nick-burrill/mPMT_Development/mPMT Assembly/Templates/Parts/readme.md

# Part Name v# # 

Part Preview

**Model Source:** \
**Part Source:** \
**Last Update:** \
**Material:** \
**Aditional Notes:**
