nick-burrill/mPMT_Development/mPMT Assembly/Parts/Acrylic Dome/v1/readme.md

# Acrylic Dome v1 # 

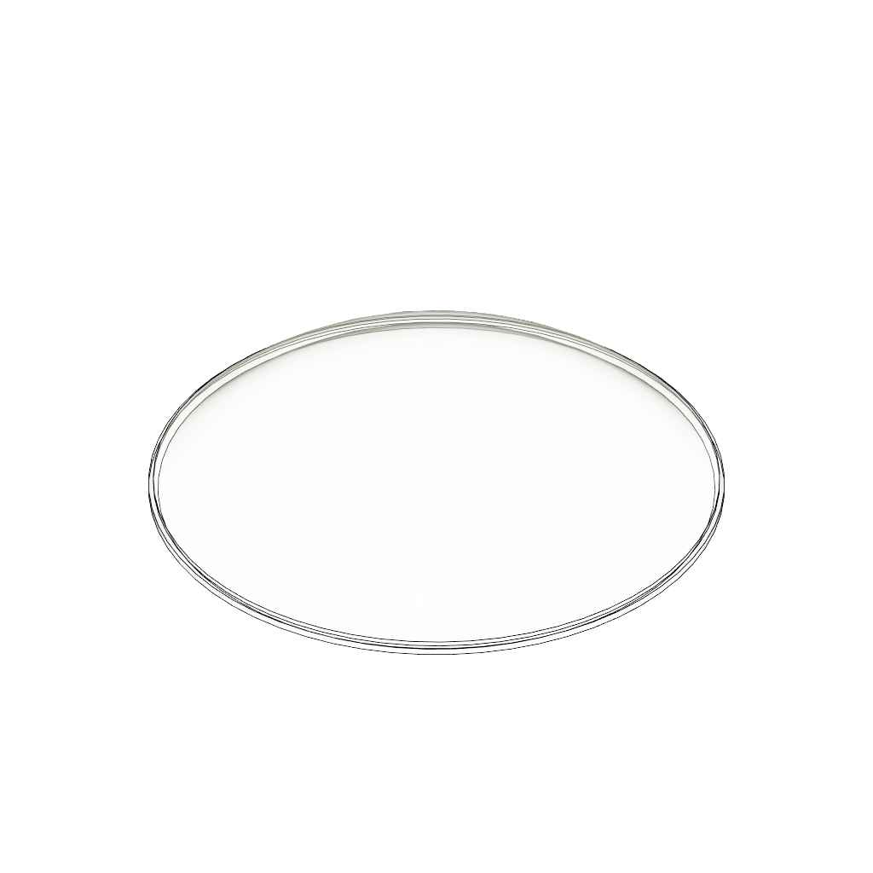
[picture p2: mPMT Assembly/Parts/Acrylic Dome/v1/thumb.png]
Part Preview


**Model Source:** Sent from previous designer \
**Part Source:** \
**Last Update:** ~September 2022 \
**Material:** Acrylic \
**Aditional Notes:**
