nick-burrill/mPMT_Development/mPMT Assembly/Parts/Aluminum Ring/v1/readme.md

# Aluminum Ring v1# # 

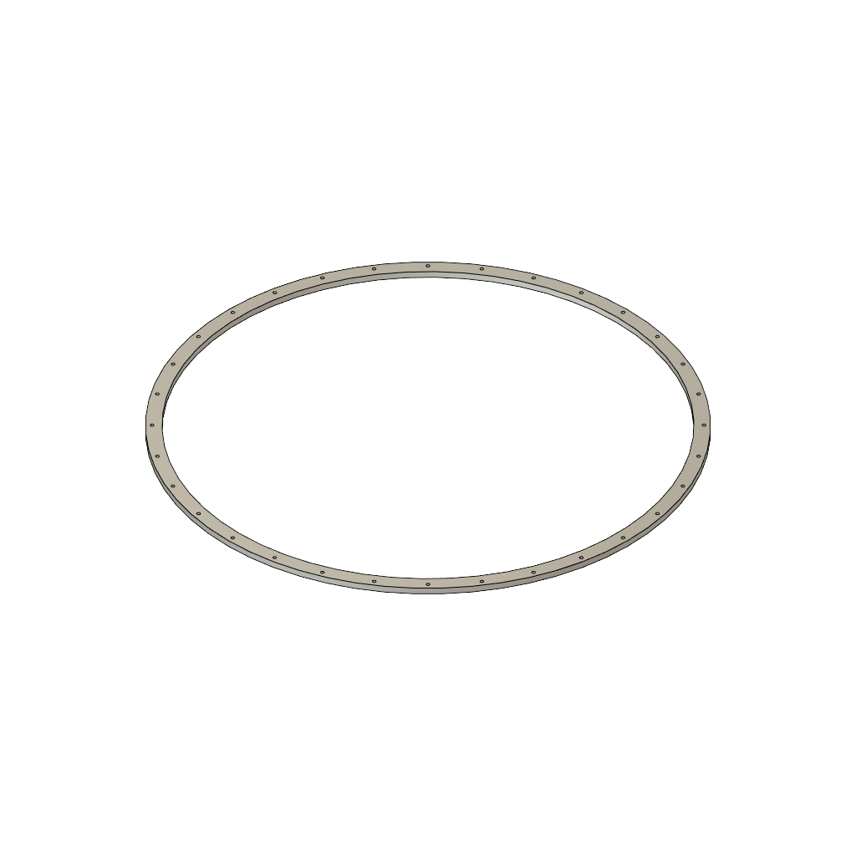
[picture p3: mPMT Assembly/Parts/Aluminum Ring/v1/thumb.png]
Part Preview


**Model Source:** Sent from previous designer \
**Part Source:** \
**Last Update:** ~September 2022 \
**Material:** 6061 Aluminum \
**Aditional Notes:**
