nick-burrill/mPMT_Development/mPMT Assembly/Parts/Back Plane/v1/readme.md

# Back Plane (XDE2411) v1 # 

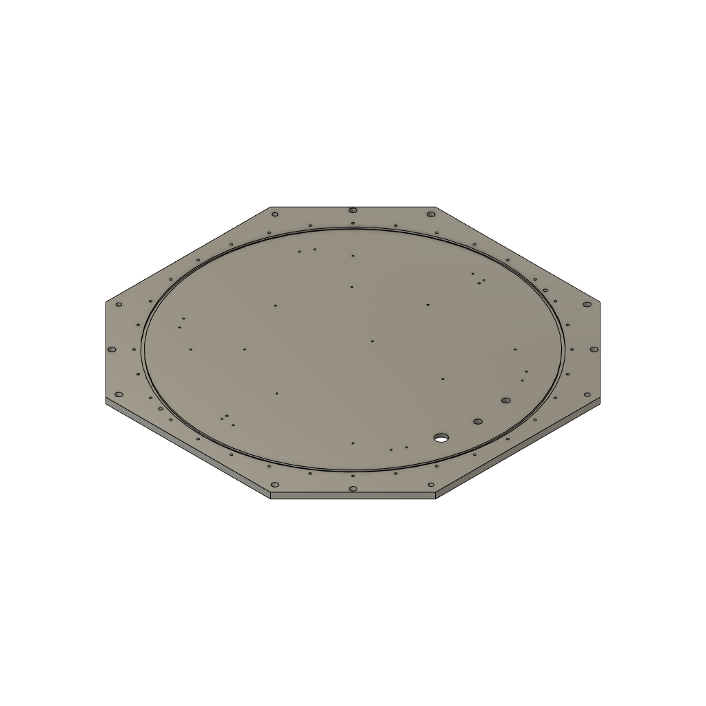
[picture p4: mPMT Assembly/Parts/Back Plane/v1/thumb.png]
Part Preview


**Model Source:** Sent from previous designer \
**Part Source:** \
**Last Update:** ~September 2022 \
**Material:** Stainless Steel\
**Aditional Notes:**
