nick-burrill/mPMT_Development/mPMT Assembly/Parts/Dome Standoff/v1/readme.md

# Dome Standoff v1 # 

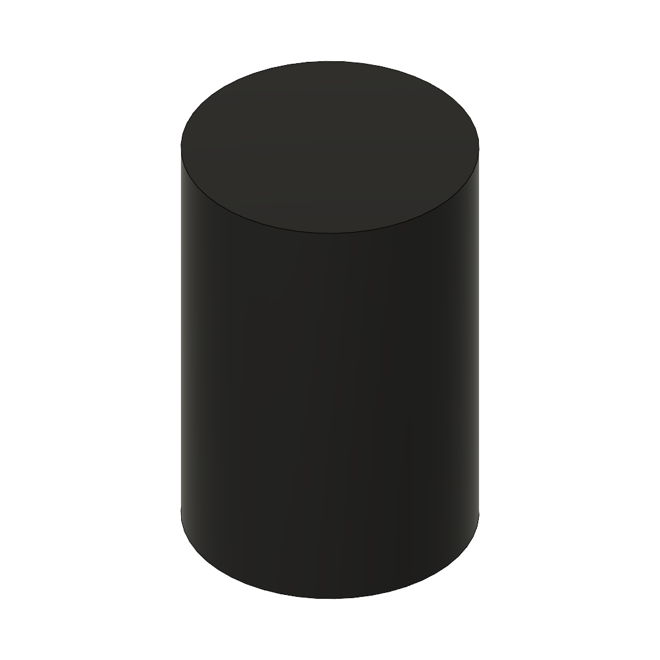
[picture p5: mPMT Assembly/Parts/Dome Standoff/v1/thumb.png]
Part Preview


**Model Source:** Modeled by Nick Burrill \
**Part Source:** Made at Carleton \
**Last Update:** November 10th 2022 \
**Material:** 1/2" Delrin rod stock \
**Aditional Notes:**
