nick-burrill/mPMT_Development/mPMT Assembly/Parts/Pillars/v1/readme.md

# Pillar (v4.0.1) v1 # 

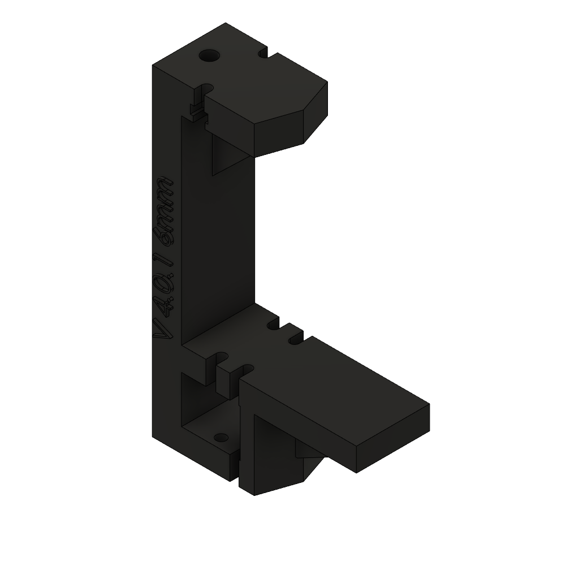
[picture p6: mPMT Assembly/Parts/Pillars/v1/thumb.png]
Part Preview


**Model Source:** Sent from previous designer \
**Part Source:** \
**Last Update:** ~September 2022 \
**Material:** 3d printed ABS \
**Aditional Notes:**
