nick-burrill/mPMT_Development/mPMT Assembly/Parts/PMT Array/v1/readme.md

# PMT Array v1 # 

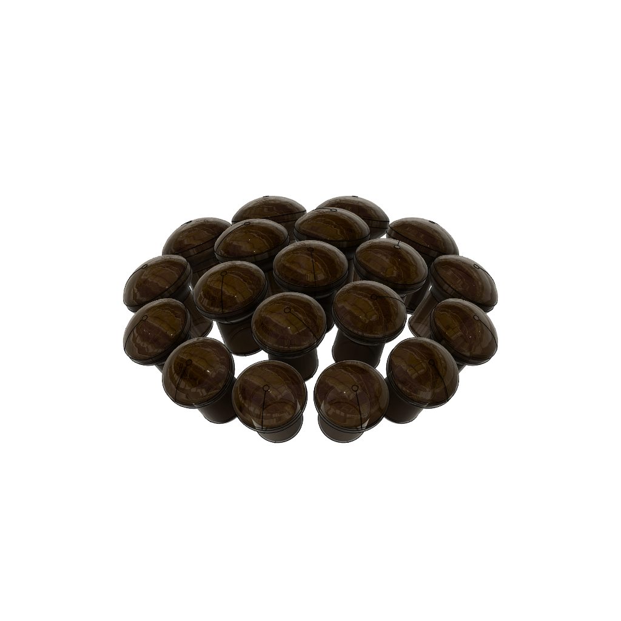
[picture p7: mPMT Assembly/Parts/PMT Array/v1/thumb.png]
Part Preview


**Model Source:** Sent from previous designer \
**Part Source:** Hamamatsu
**Last Update:** ~September 2022 \
**Material:** \
**Aditional Notes:** Dummy PMT are a baseless varient of [Hamamatsu R14374 Photomultiplier Tube](https://www.hamamatsu.com/us/en/product/optical-sensors/pmt/pmt_tube-alone/head-on-type/R14374.html)
