nick-burrill/mPMT_Development/mPMT Assembly/Parts/PVC Cylinder/v1/readme.md

# PVC Cylinder (XDE2431) v1 # 

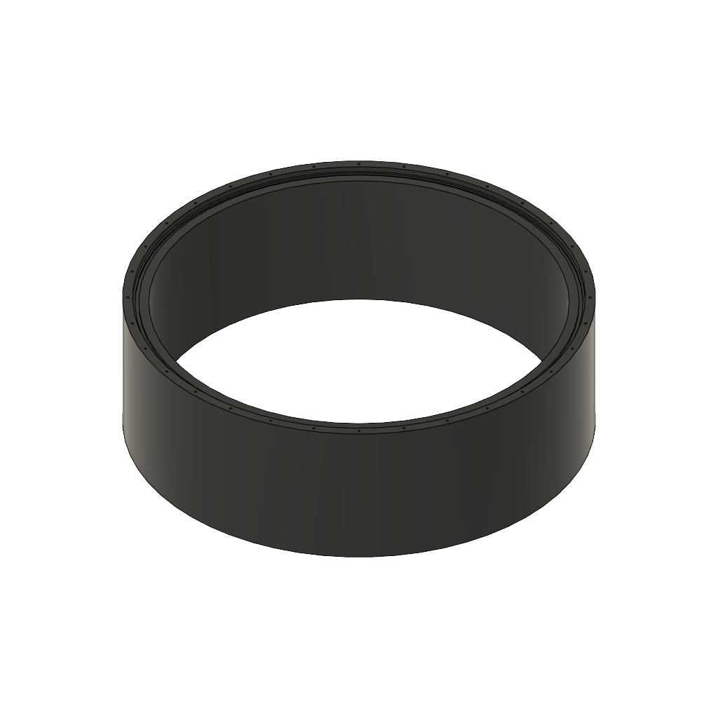
[picture p8: mPMT Assembly/Parts/PVC Cylinder/v1/thumb.png]
Part Preview


**Model Source:** Sent from previous designer \
**Part Source:** Made at Carleton \
**Last Update:** ~September 2022 \
**Material:** PVC pipe \
**Aditional Notes:**
