nick-burrill/mPMT_Development/mPMT Assembly/Parts/Acrylic Dome/v1/Acrylic Dome v1.step

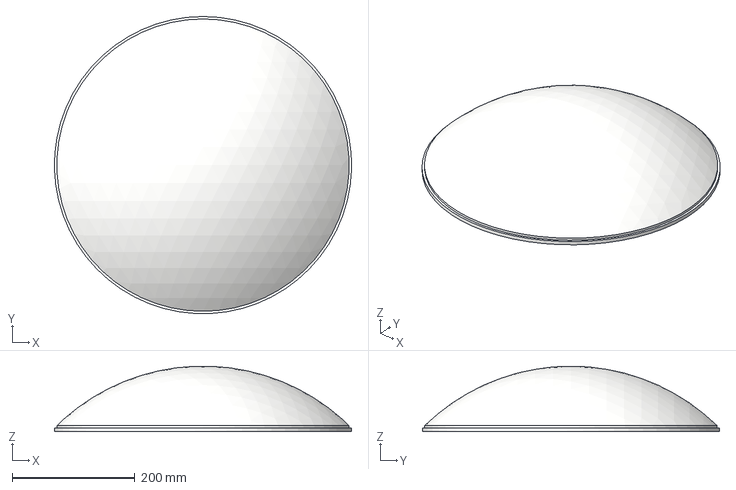
[picture p10: CAD file, 2023-03-15]
mPMT Assembly/Parts/Acrylic Dome/v1/Acrylic Dome v1.step
484.8 x 484.7 x 106.7 mm
