nick-burrill/mPMT_Development/mPMT Assembly/Parts/Aluminum Ring/v1/Aluminum Ring (XDE2255) v1.step

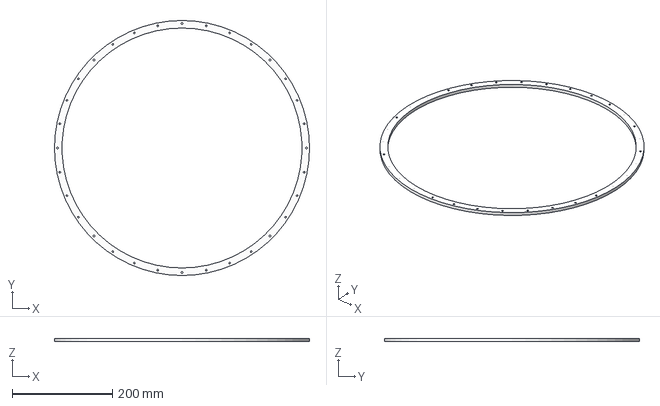
[picture p11: CAD file, 2023-03-15]
mPMT Assembly/Parts/Aluminum Ring/v1/Aluminum Ring (XDE2255) v1.step
508.0 x 508.0 x 6.35 mm
