nick-burrill/mPMT_Development/mPMT Assembly/Parts/Dome Standoff/v1/Dome Standoff v1.step

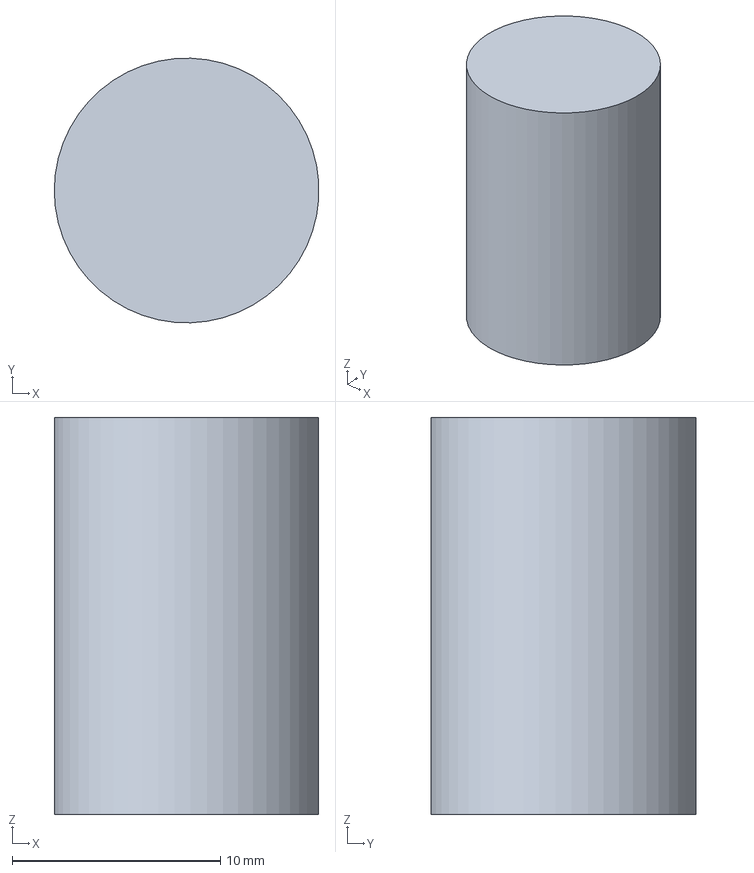
[picture p13: CAD file, 2023-03-15]
mPMT Assembly/Parts/Dome Standoff/v1/Dome Standoff v1.step
12.7 x 12.7 x 19.0 mm
