nick-burrill/mPMT_Development/mPMT Assembly/Parts/Pillars/v1/Pillar (v4.0.1) v1.step

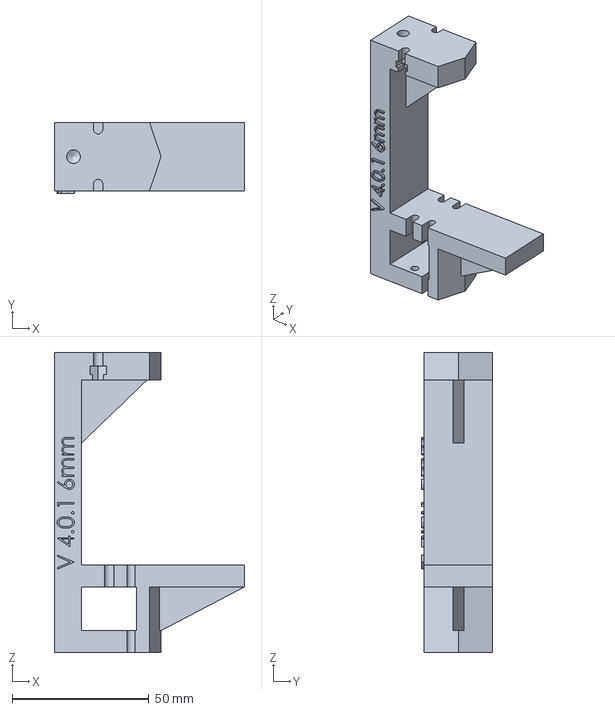
[picture p14: CAD file, 2023-03-15]
mPMT Assembly/Parts/Pillars/v1/Pillar (v4.0.1) v1.step
69.5 x 26.0 x 109.6 mm
