nick-burrill/mPMT_Development/mPMT Assembly/Parts/PMT Array/v1/PMT Array v1.step

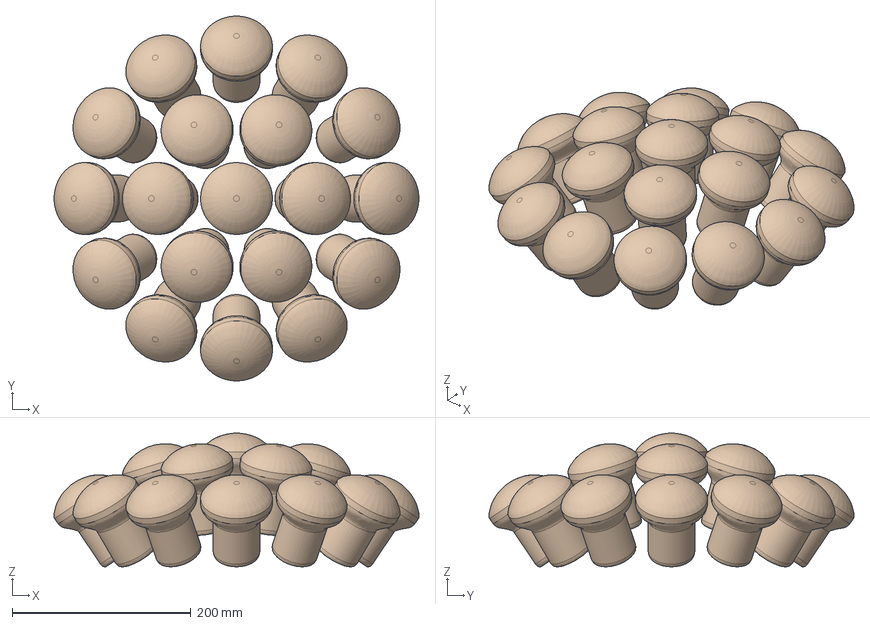
[picture p15: CAD file, 2023-03-15]
mPMT Assembly/Parts/PMT Array/v1/PMT Array v1.step
408.0 x 408.0 x 149.3 mm
Hollow PMT rev 2 x 19
