nick-burrill/mPMT_Development/mPMT Assembly/Parts/PVC Cylinder/v1/PVC Cylinder (XDE2431) v1.step

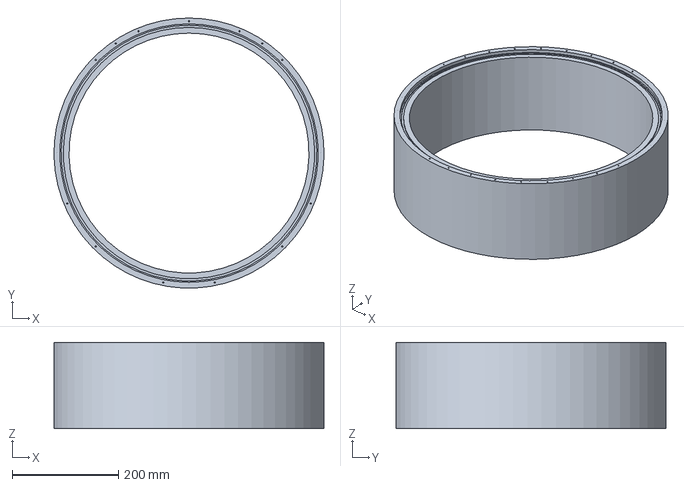
[picture p16: CAD file, 2023-03-15]
mPMT Assembly/Parts/PVC Cylinder/v1/PVC Cylinder (XDE2431) v1.step
507.8 x 507.6 x 161.8 mm
