nick-burrill/mPMT_Development/mPMT Assembly/Parts/Support Matrix/v1/Support Matrix v1 (With cross channels).stl

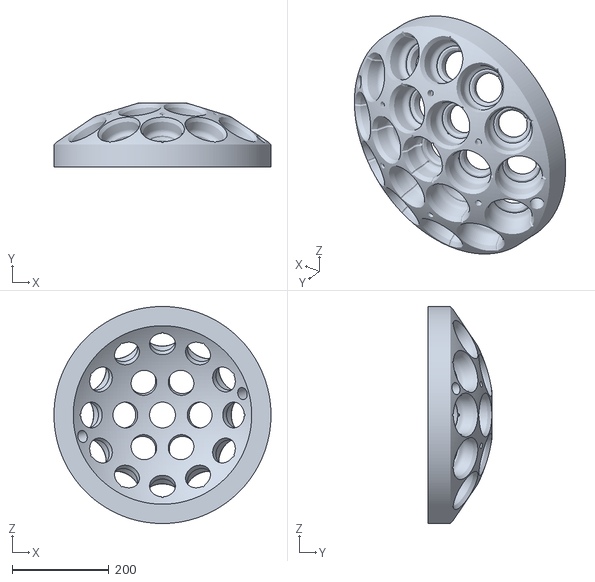
[picture p17: CAD file, 2023-03-15]
mPMT Assembly/Parts/Support Matrix/v1/Support Matrix v1 (With cross channels).stl
449.2 x 133.4 x 449.2
