nick-burrill/mPMT_Development/(list of files, cad)

Other CAD files:
mPMT Assembly/Parts/Support Matrix/v1/Custom Modified Matrix v1 (No cross channels).step
mPMT Assembly/Parts/Support Matrix/v1/Custom Modified Matrix v1 (With cross channels).step
mPMT Assembly/Assembly/V1/Assembly v2.f3z
mPMT Assembly/Parts/Support Matrix/v1/Custom Modified Matrix v1.f3d
