nick-burrill/mPMT_Development/mPMT Assembly/Templates/Assembly/readme.md

# Part Name v# # 

Part Preview

**Model Source:** \
**Last Update:** \
**Aditional Notes:** \
**Part Versions Used:** \
*
